ss7478/Plotter/docs/schematic/Принципиальная схема Э3.pdf

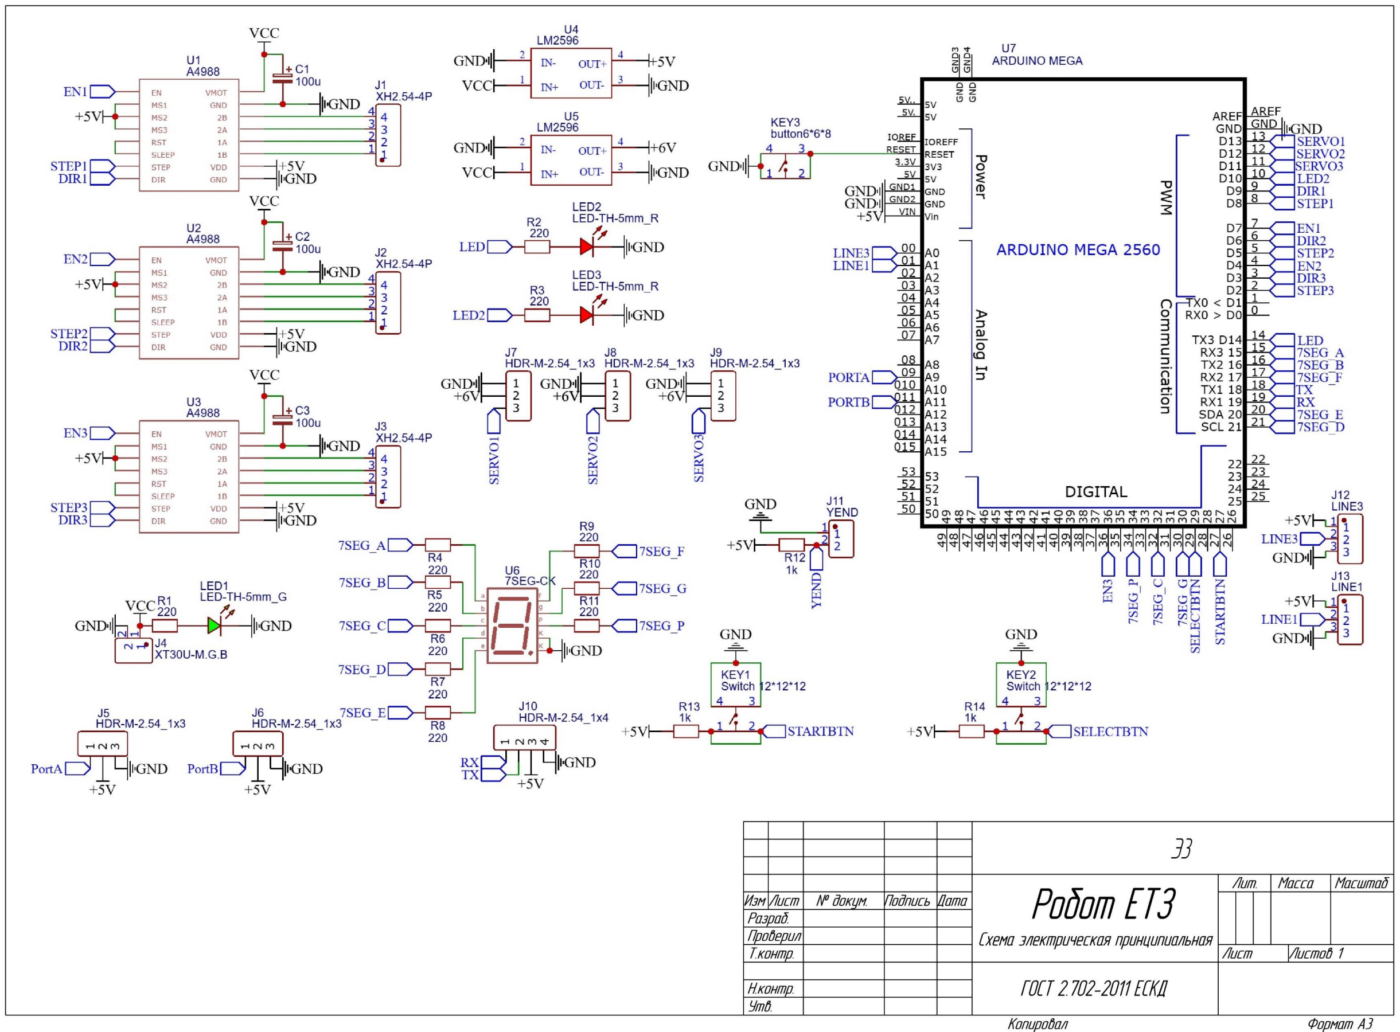
[picture p2: page 1]

2
