ss7478/Plotter/docs/3Д модель.jpg

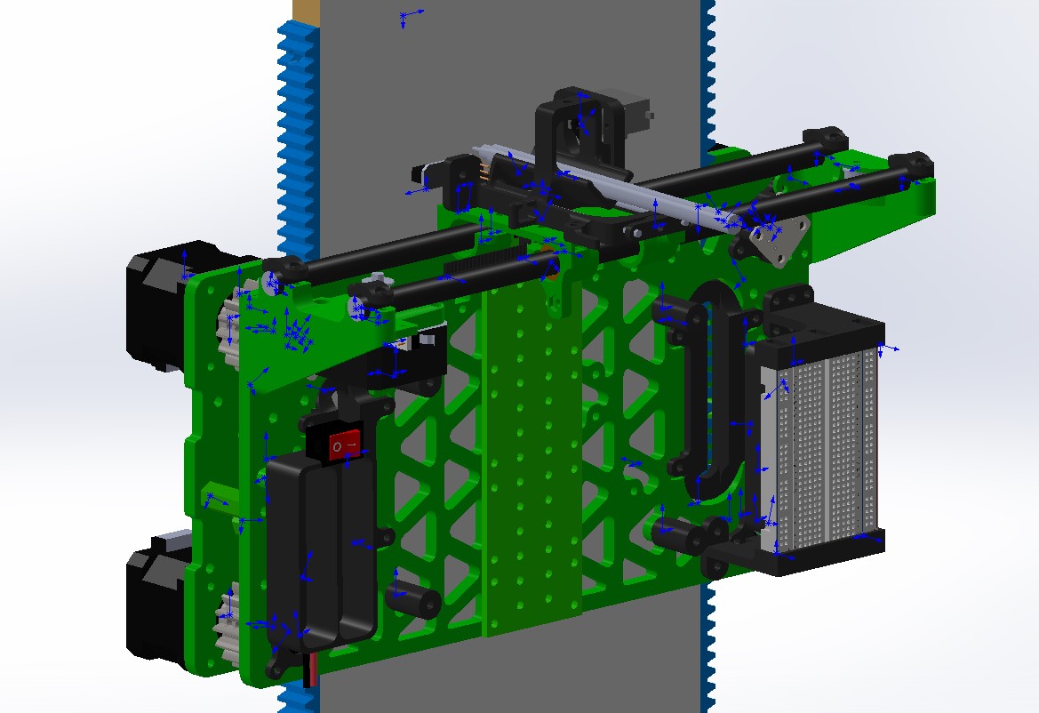
docs/3Д модель.jpg
