ss7478/Plotter/docs/schematic/Трассировка платы.jpg

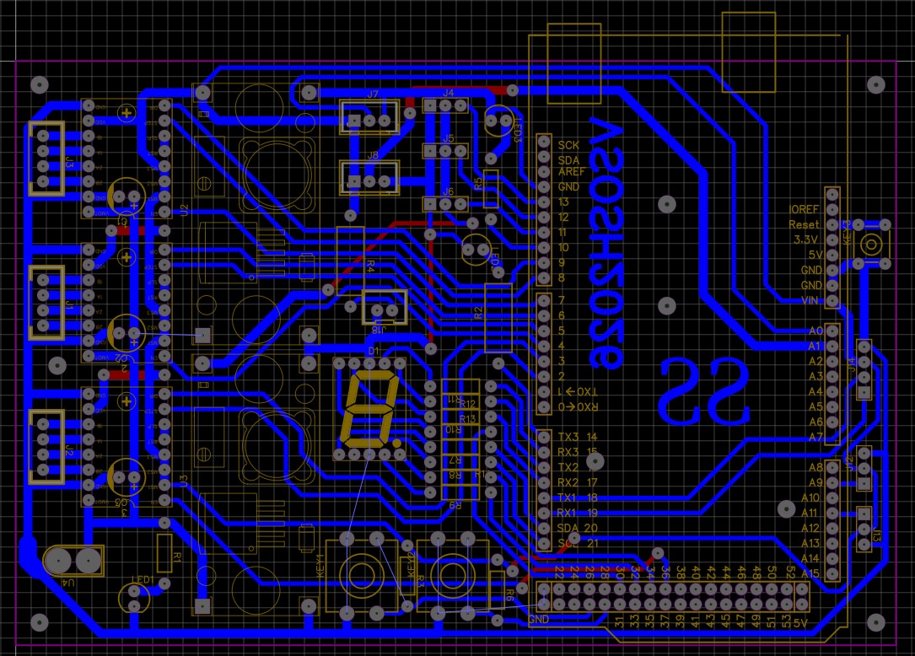
docs/schematic/Трассировка платы.jpg
