ss7478/Plotter/docs/Вид сверху.jpg

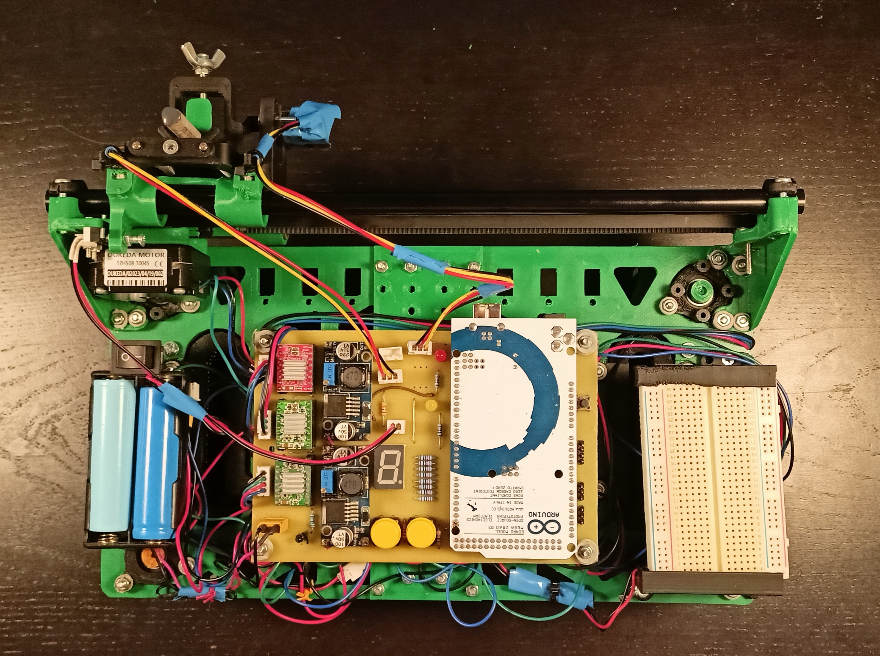
docs/Вид сверху.jpg
