ss7478/Plotter/docs/Вид слева.jpg

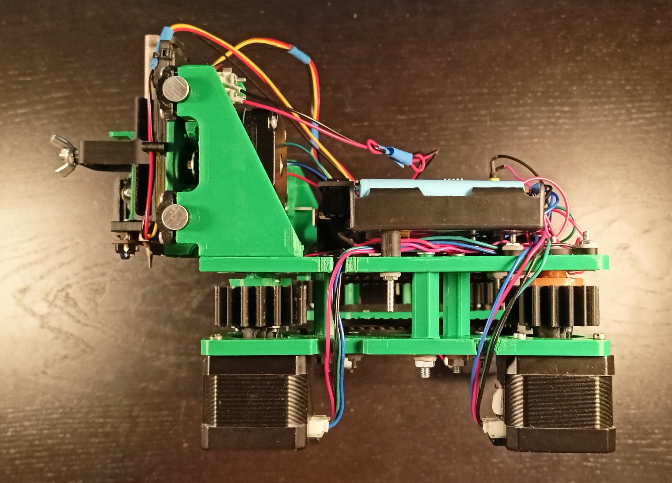
docs/Вид слева.jpg
