ss7478/Plotter/docs/Вид спереди.jpg

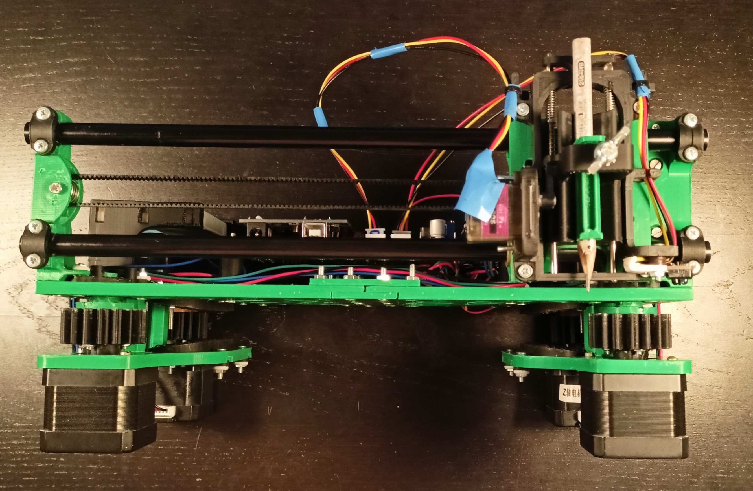
docs/Вид спереди.jpg
