ss7478/Plotter/docs/Вид справа.jpg

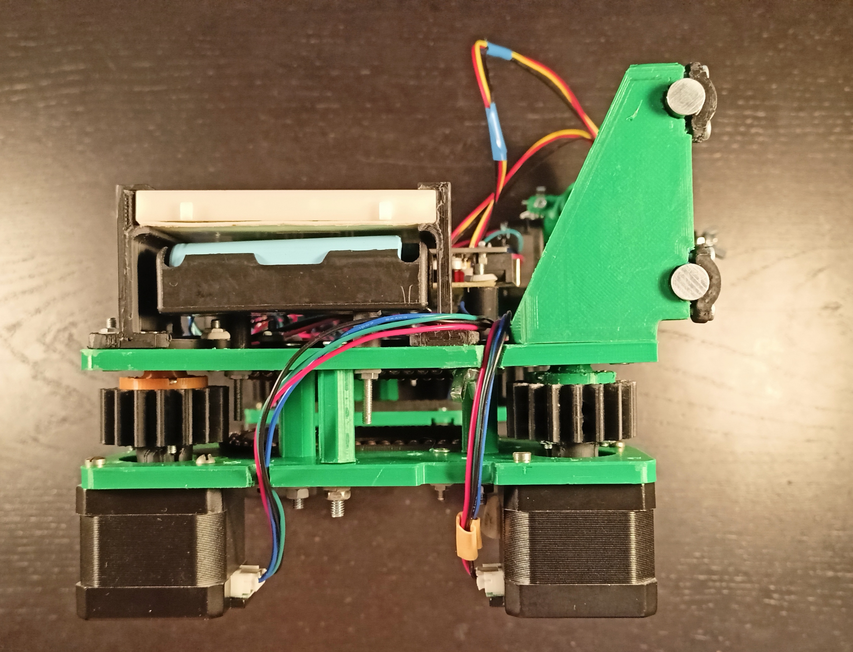
docs/Вид справа.jpg
