ss7478/Plotter/docs/Процесс сборки.jpg

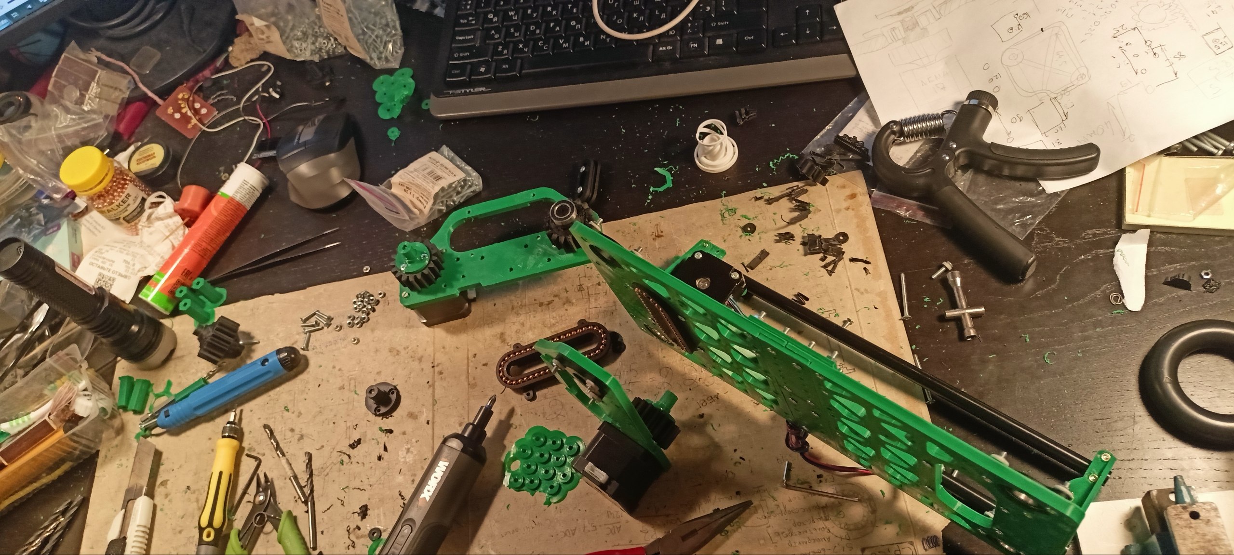
docs/Процесс сборки.jpg
