ss7478/Plotter/docs/schematic/Структурная схема Э1.pdf

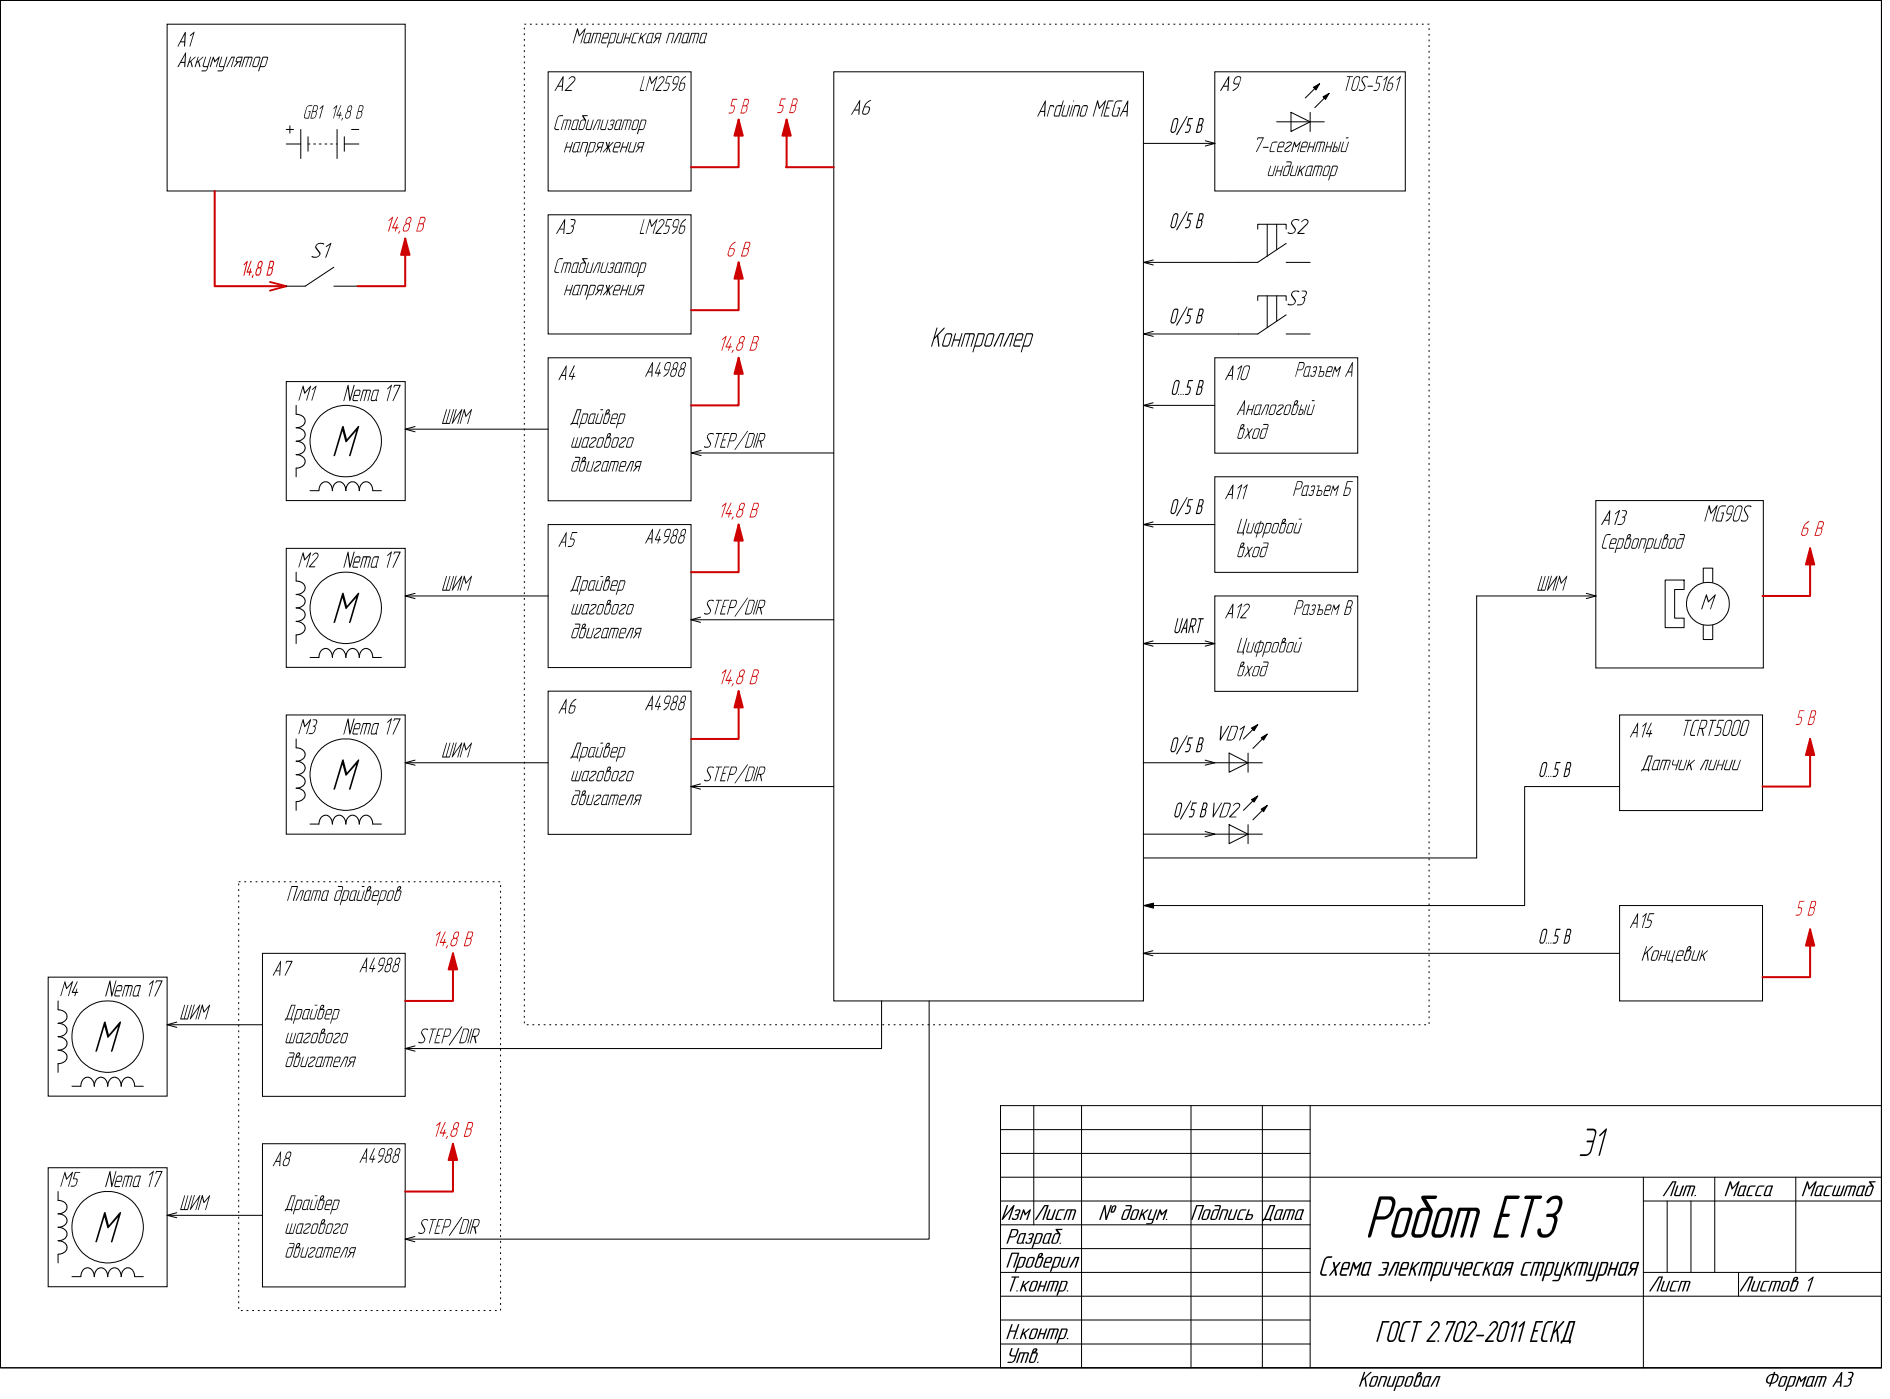
[picture p10: page 1]
