ss7478/Plotter/(commit log)

2026-07-07 Первоначальная заливка кода
2026-07-07 Создан README.md
2026-07-07 Обновлен код и структура папок, названия некоторых файлов
2026-07-07 Обновлен README.md, добавлены некоторые фотографии
